sunliguo2020/ESP32-LED-Clock/开源广场附件/LED时钟资料包/esp32开发板接线说明/2122c8e02119c6153c7276ac0d81b17.jpg

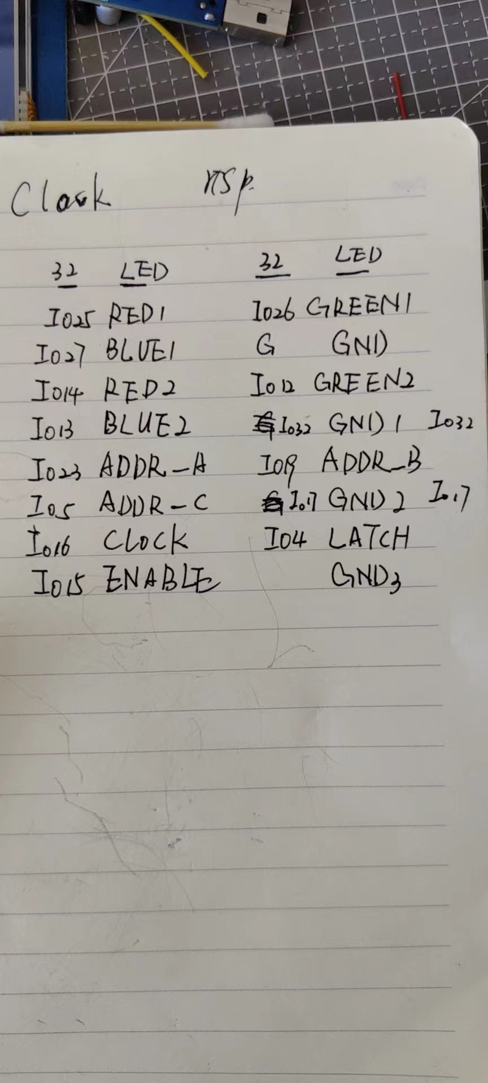
开源广场附件/LED时钟资料包/esp32开发板接线说明/2122c8e02119c6153c7276ac0d81b17.jpg
