sunliguo2020/ESP32-LED-Clock/开源广场附件/LED时钟资料包/下载说明/1.png

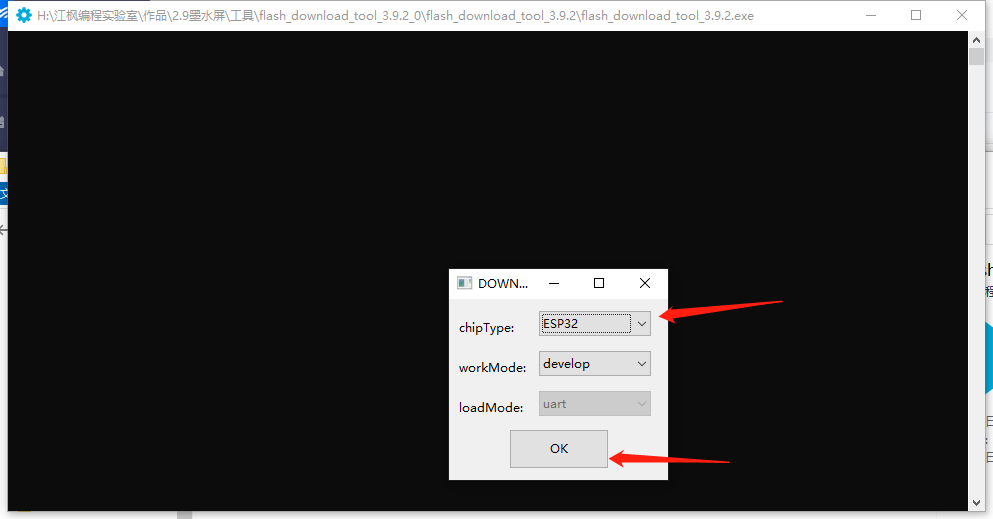
开源广场附件/LED时钟资料包/下载说明/1.png
