sunliguo2020/ESP32-LED-Clock/pcb/SCH_Schematic1_2026-06-01.pdf

IO0 25 IO4 26 IO16 27 IO17 28 IO5 29 IO18 30 IO19 31 NC 32 IO21 33 U0RXD 34 U0TXD 35 IO22 36 IO23 37 GND 38

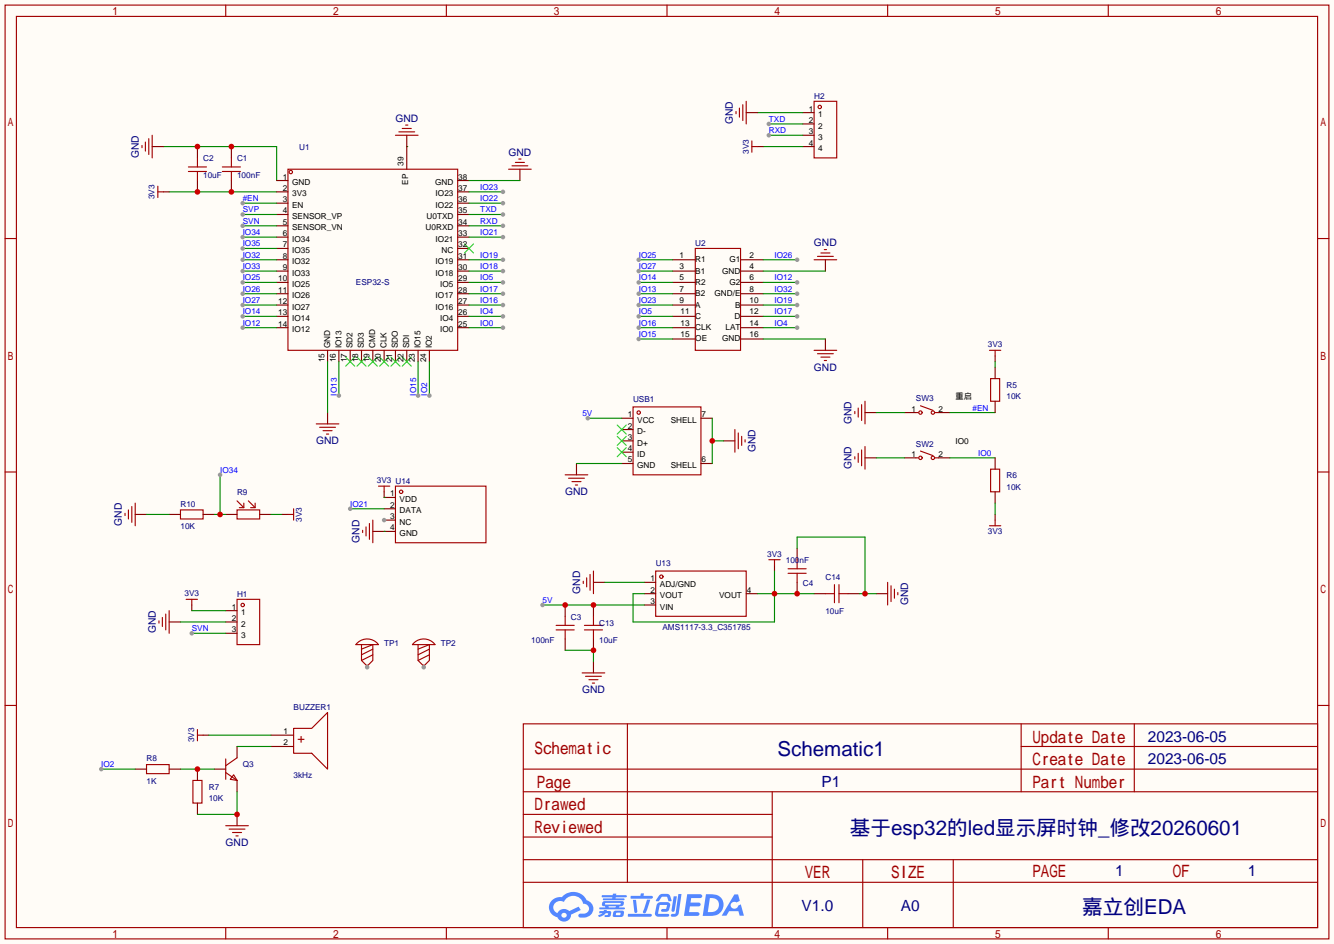
[picture p5: page 1]
