sunliguo2020/ESP32-LED-Clock/pcb/PCB_PCB1_2026-06-01.pdf

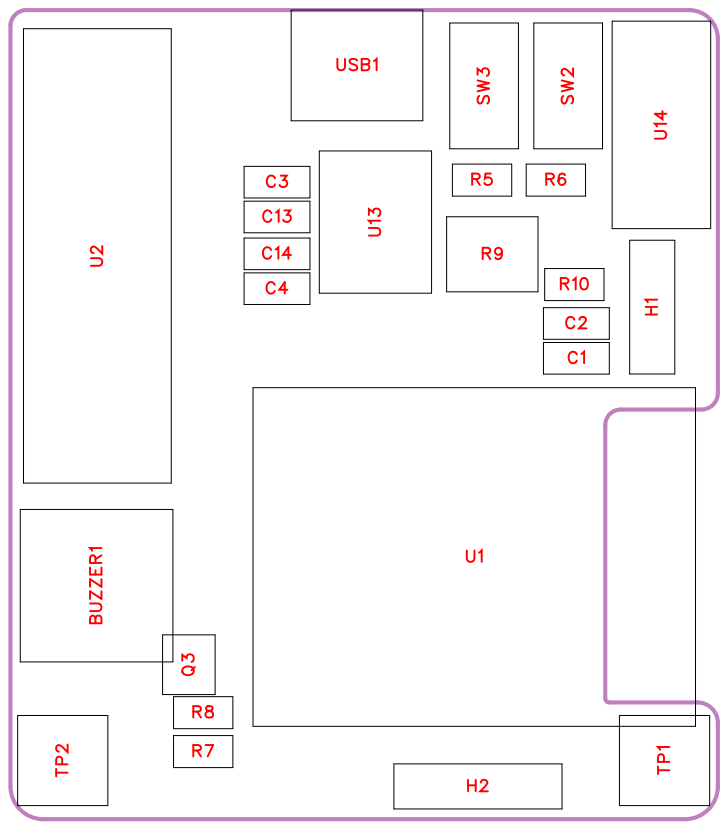
[picture p6: page 1]

C3 | R5 | R6
C13 | R9

No. | Quantity | Comment | Designator | Footprint | Value | Manufacturer Part | Manufacturer | Supplier Part | Supplier | LCSC Stock | LCSC Price
1 | 1 | 3kHz | BUZZER1 | BUZ-TH_BD 9.0-P5.00-D0 .6-FD | 3kHz | HNB09A03 | 华能 | C96102 | LCSC | 15276 | 1.436
2 | 3 | 100nF | C1,C3,C4 | C0805 | 100nF
3 | 3 | 10uF | C2,C13,C14 | C0805 | 10uF
4 | 1 | HDR-M_2.54 _1x3P | H1 | HDR-TH_3P-P2.54-V-M | | | | C2937625 | | 9416 | 0.1201
5 | 1 | HDR-M_2.54 _1x4P | H2 | HDR-TH_4P-P2.54-V-M | | | | C492403 | | 3126 | 0.1643
6 | 1 | S8050_NPN | Q3 | SOT-23_L2.9 -W1.3-P1.90-LS2.4-BR | | | | C444723 | | 1014 | 0.0531
7 | 4 | 10K | R5,R6,R7,R10 | R0805 | 10K | | | C319941 | | 850 | 0.1438
8 | 1 | 1K | R8 | R0805 | 1K
9 | 1 | GL5506 （4-7 K ） | R9 | RES-TH_L5. 1-W4.3-P3.0 0-D0.5 | | GL5506 （4-7 K ） | JCHL(晶创和 立) | C11299 | LCSC | 2895 | 0.2775
10 | 2 | YTS1C0192 ABG00 | SW2,SW3 | SW-SMD_L6 .0-W4.0-LS7. 2 | | YTS1C0192 ABG00 | YIYUAN(怡远 ) | C2985752 | LCSC | 539 | 0.6863
11 | 2 | M3螺丝 | TP1,TP2 | M3螺丝
12 | 1 | ESP32-S | U1 | WIRELM-SM D_ESP32-S | | ESP32-S | Ai-Thinker( 安 ) 信可 | C277944 | LCSC
13 | 1 | HUB75/HUB 75E | U2 | IDC-TH_Z-23 1011816106 | | | | C3406 | | 13063 | 0.8347
14 | 1 | AMS1117-3. 3 | U13 | SOT-223_L6. 5-W3.5-P2.3 0-LS7.0-BR | | AMS1117-3. 3 | PUOLOP( 迪 浦 ) | C351785 | LCSC
15 | 1 | DHT11 | U14 | SENSOR-TH _DHT11 | | DHT11 | 广州奥松 | C117051 | LCSC | 3814 | 8.9
16 | 1 | MICRO-11-G 5P3-A1T2 | USB1 | MICRO-USB-SMD_MICR O-12-G2P3-A1T2 | | MICRO-11-G 5P3-A1T2 | Yuandi(台湾 ) 元迪 | C2874592 | LCSC | 36 | 0.5368

JLCPCB Stock | JLCPCB Price
87690 | 1.436
581857 | 0.12
64113 | 0.166
54560 | 0.0535
22483 | 0.144
29032 | 0.278
2713 | 0.686
0 | 25.09
81059 | 0.835
0 | 0.428
4577 | 8.9
181 | 0.537

# GND DA-Clock|江枫

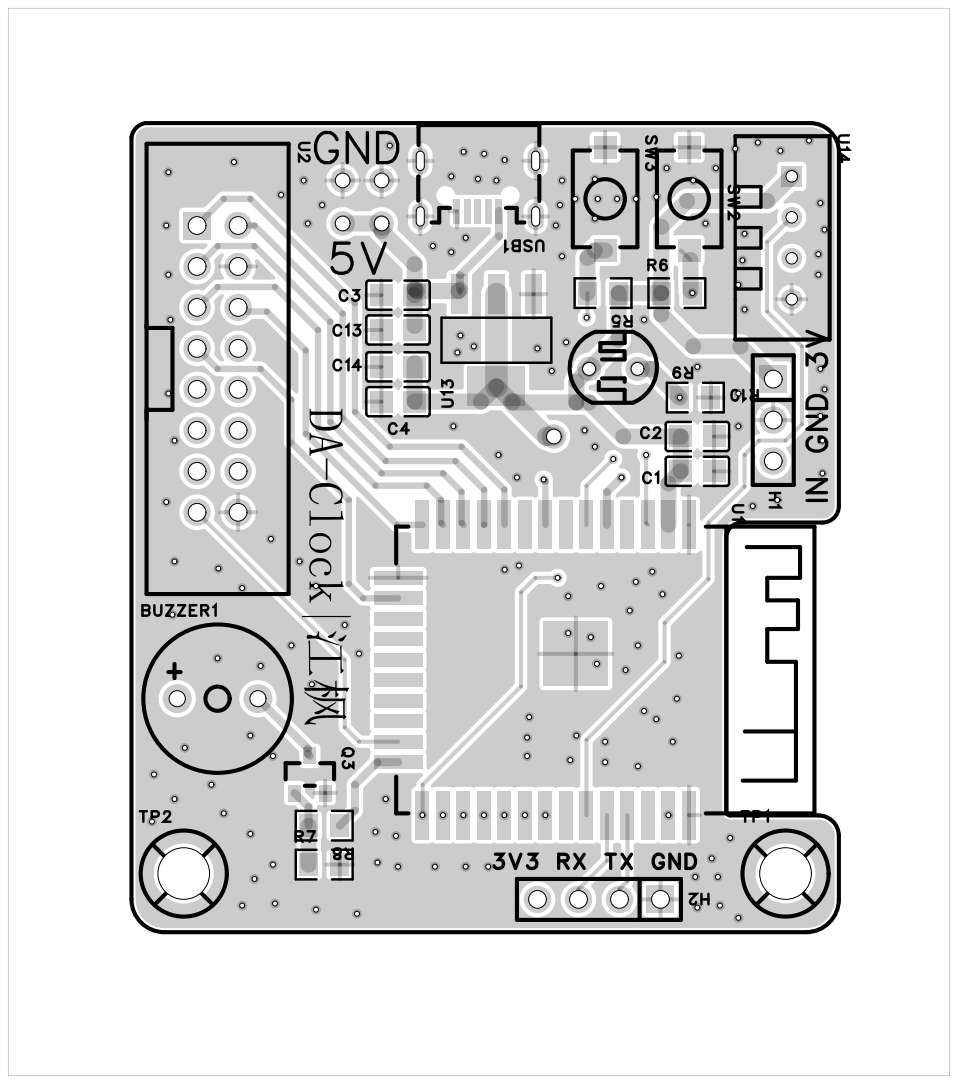
[picture p7: page 5]

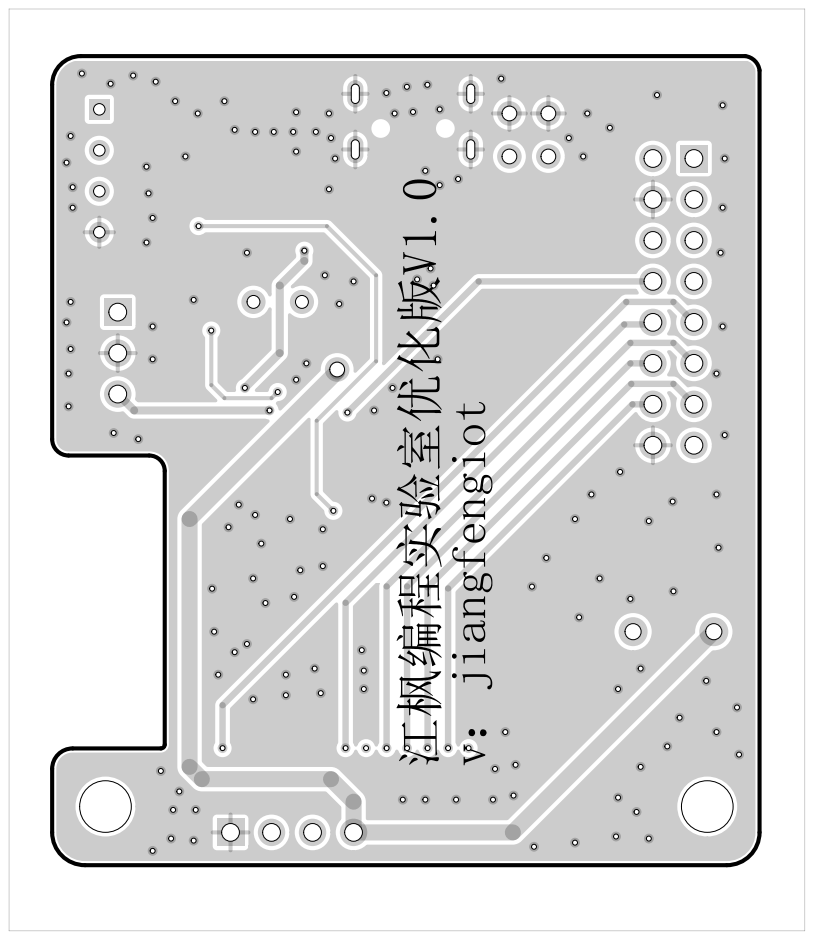
[picture p8: page 6]

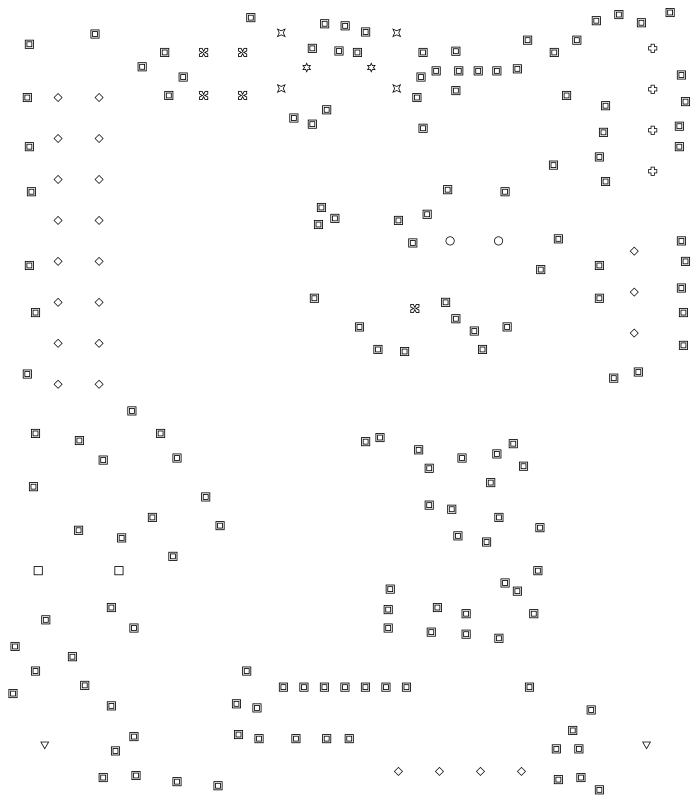
[picture p9: page 7]
