sunliguo2020/ESP32-LED-Clock/开源广场附件/LED时钟资料包/PCB文件、电路图/PCB_PCB1_2023-05-23.pdf

5V

## GND

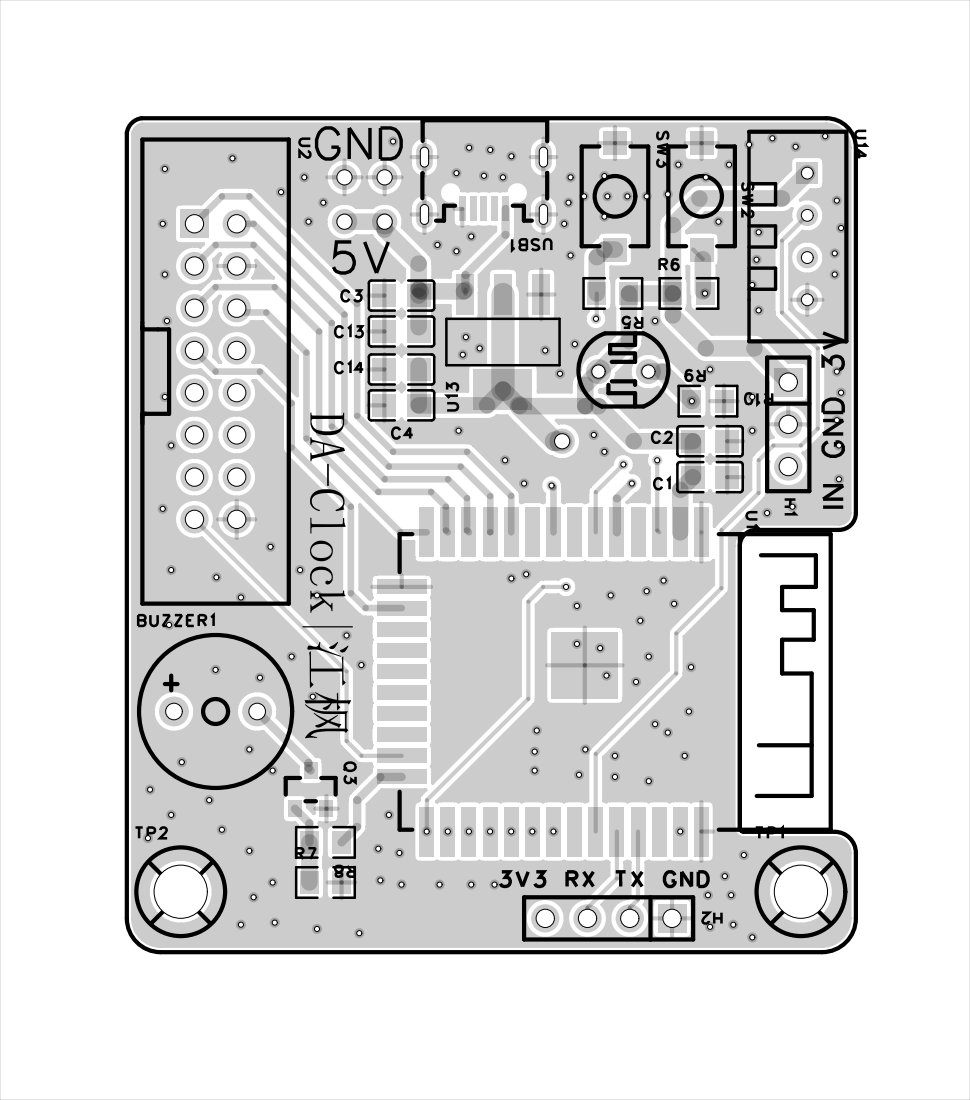
[picture p10: page 1]

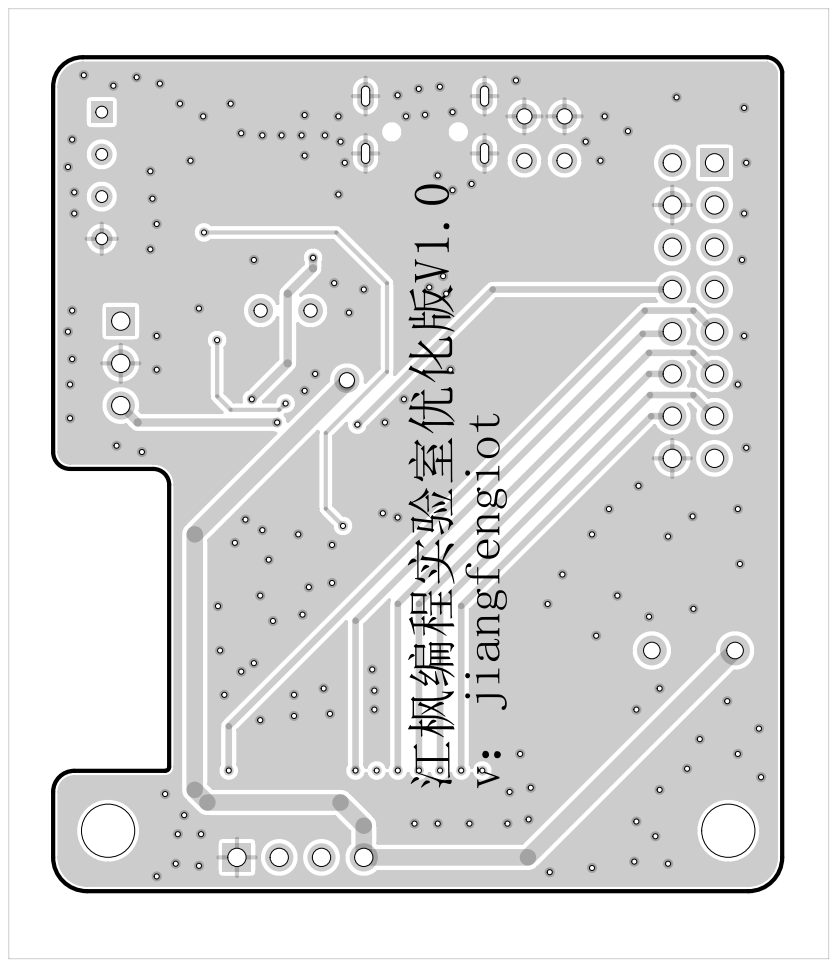
[picture p11: page 2]

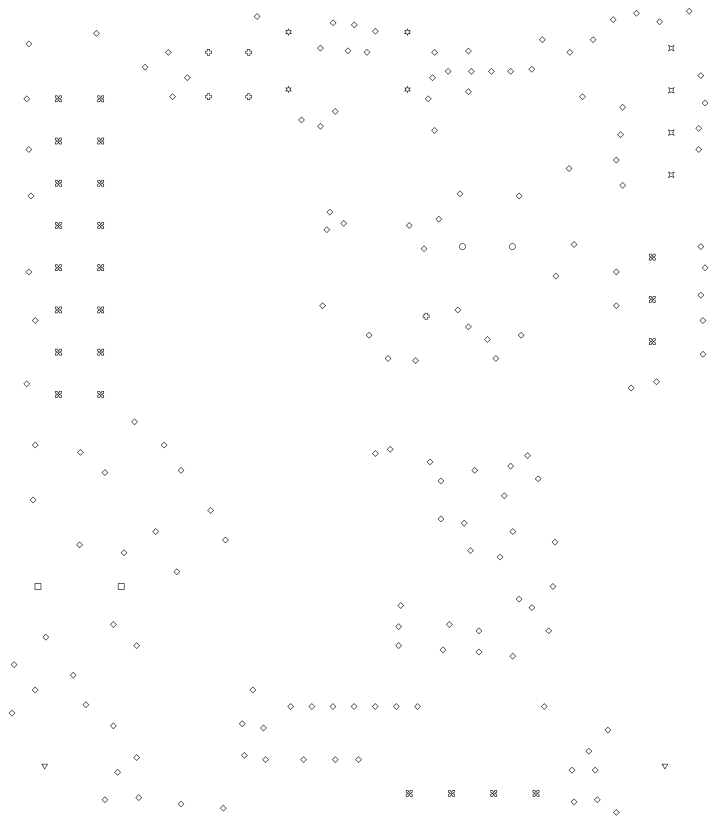
[picture p12: page 3]
