sunliguo2020/ESP32-LED-Clock/(commit log)

2026-06-01 feat: 优化项目结构和文档，新增固件代码和Web配网功能
2026-06-01 docs: 补充刷机方式说明，Type-C仅用于供电
2026-06-02 docs: 更新项目结构，新增6月2日原理图网表文件
2026-06-02 docs: 更新项目结构，新增开源广场附件资料目录
2026-06-02 refactor: 将源码拆分为多文件结构，优化README文档
2026-06-03 feat: 支持保存多组 WiFi 配置（最多 5 组）
